AlexGyver/NixieClock/schemes/список компонентов.xlsx

Компонент | Номинал | Корпус | Количество
Платформа | ArduinoNano | ARDUINO_NANO | 1
Дешифратор | k155id1 | 16DIP300 | 1
ШИМ-контроллер | MC34063 | 8DIP300 | 1
Резистор | 10k, 1M, 390k, 330, 10k, 470, 10k, 4.7K, 1k, 1k, 10k, 3k, 33k, 330, 250k
Резистор | Резистор 0.22 Ом 2 Вт вместо резистора 220 Ом на схеме!
Диод | HER106 | DIODE-1N4148 | 1
Оптопара | TLP627 | DIP-4 | 7
Датчик температуры и влажности | DHT22, ds18b20 (не работает в этой схеме) | RHT03_DHT-22 | 1
Транзистор | bc547 | BC547 | 1
Транзистор | KT3102,KT3107 | TO-92(TO-92-3)-F | 1
Транзистор | IRF840 |  | 1
Конденсатор | 10uf | CAP-D5.0xF2.0 | 2
Конденсатор | 4.7UF,510P,0.1uf,C1,C2 |  | 1
Индуктивность | 240uh | Axial | 1
Стабилизатор напряжения | LM7805 |  | 1
