AlexGyver/NixieClock/(threads)

Thread 1 (2018-12-21):

Принципиальная схема

etomarat, 2018-12-21:
Привет! А есть принципиальная схема? Я хочу свою плату ЛУТом сделать с другой компоновкой (результатом поделюсь)

technotrasher, 2019-12-04:
>
>
> Привет! А есть принципиальная схема? Я хочу свою плату ЛУТом сделать с другой компоновкой (результатом поделюсь)

Я отказался от изготовления платы утюжным способом. она очень сложная и качество дорожек не будет достаточным. вариант с фоторезистом будет более точным. но плата двухсторонняя. не рекомендую. заказал китайцам за 8 у.ё. а вот принципиалка очень нужна. я мог пересобрать обратно в принципиалку. но не стал тратить время. кстати, я доработал плату. то что в проекте - сделано левой ногой. с нарушением правил толщин дорожек, именовании шин и т.д.

Thread 2 (2019-02-22):

А что есть в схеме С1 и С2

fogddragon, 2019-02-22:
В схемен и на плате шелкографией нанесены места под С1 и С2 ?что это? судя по  списку =компонентов это конденсаторы, какой нужны емкости?

x3mEr, 2019-09-19:
C1 - должно быть, электролит (6.3V, 47-100 мкФ).

technotrasher, 2019-12-04:
>
>
> C1 - должно быть, электролит (6.3V, 47-100 мкФ).

Неверно. исходя из схемы подключения LM7805 конденсаторы задаются так - https://ruselectronic.com/_files/200000850-1750b184b4/7805.JPG

x3mEr, 2019-12-05:
Т

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

Точно.
